dongxuanhien/Project_Vixuly/Video_Ảnh/Testboard/Ảnh 1.jpg

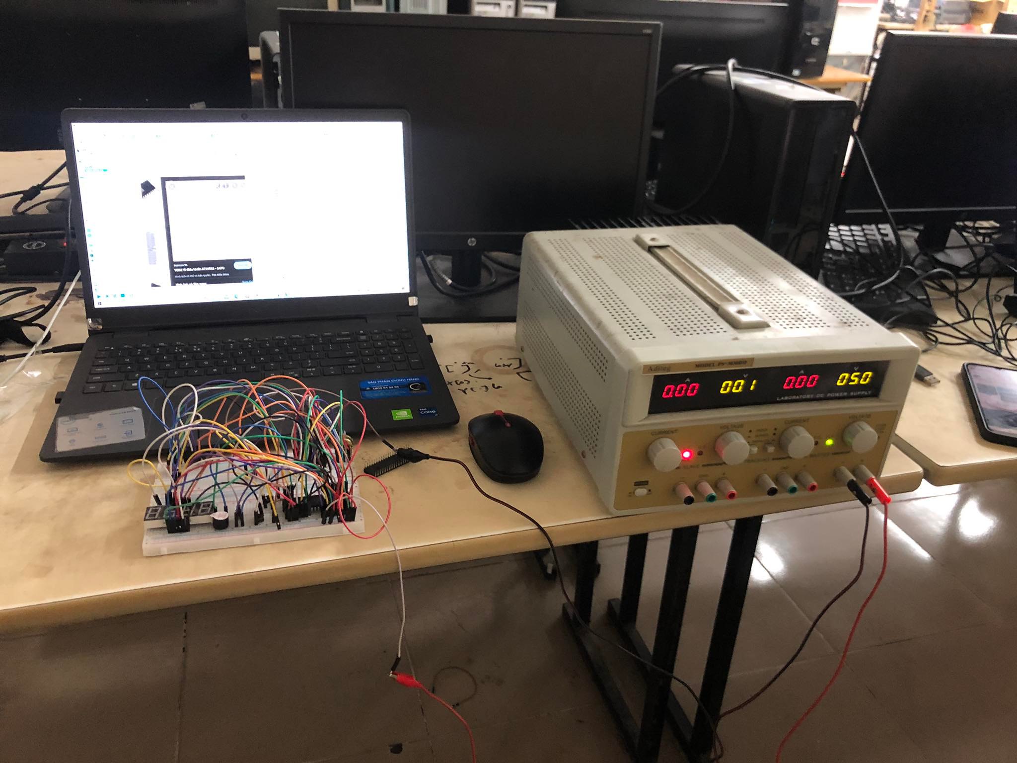
Video_Ảnh/Testboard/Ảnh 1.jpg
