dongxuanhien/Project_Vixuly/Video_Ảnh/Testboard/Ảnh 2.jpg

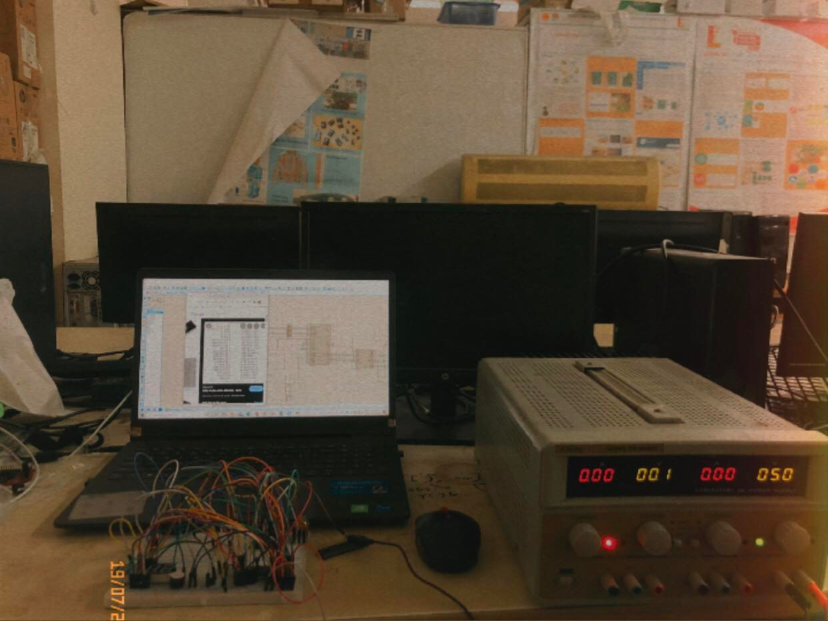
Video_Ảnh/Testboard/Ảnh 2.jpg
