dongxuanhien/Project_Vixuly/Video_Ảnh/Mạch in/Ảnh 1.jpg

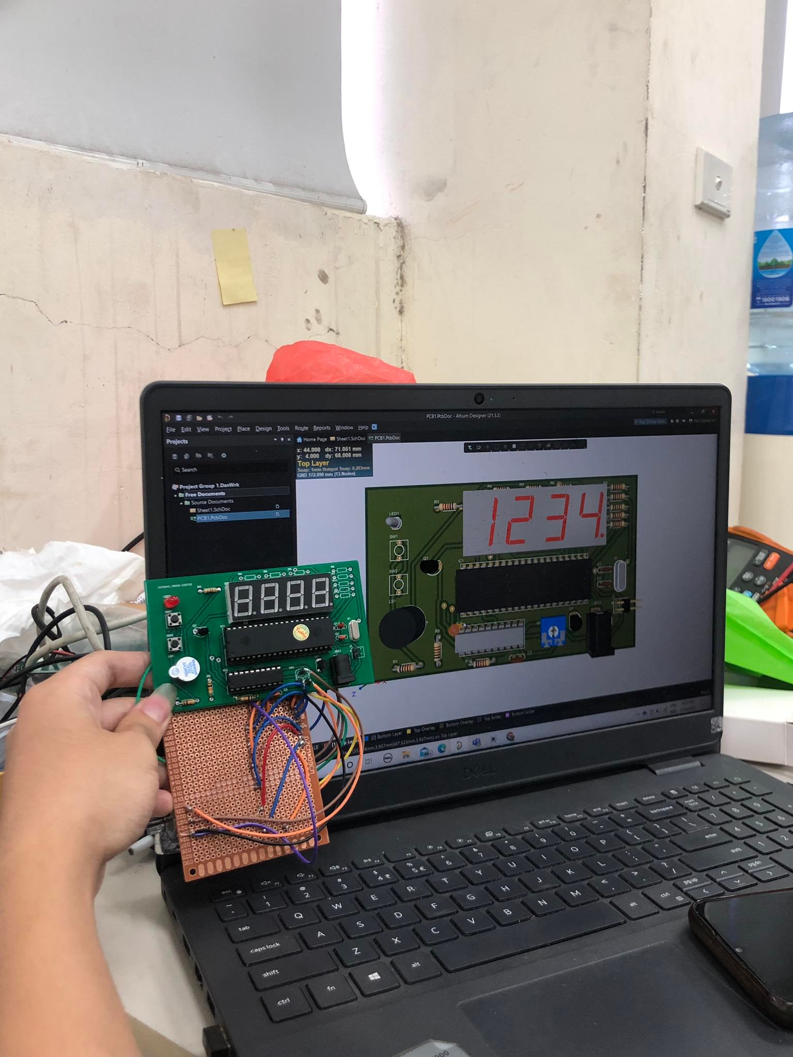
Video_Ảnh/Mạch in/Ảnh 1.jpg
