dongxuanhien/Project_Vixuly/(list of files, cad)

Other CAD files:
mophong_code/C/main.OBJ
mophong_code/asem/hoho.OBJ
mophong_code/C/delay.obj
