dongxuanhien/Project_Vixuly/(list of files, drawings)

Other design files:
mophong_code/mophong/adc.pdsprj
